valordk/chordata/Renders/Mini HUBs and Mini K-Ceptors - 04p.JPG

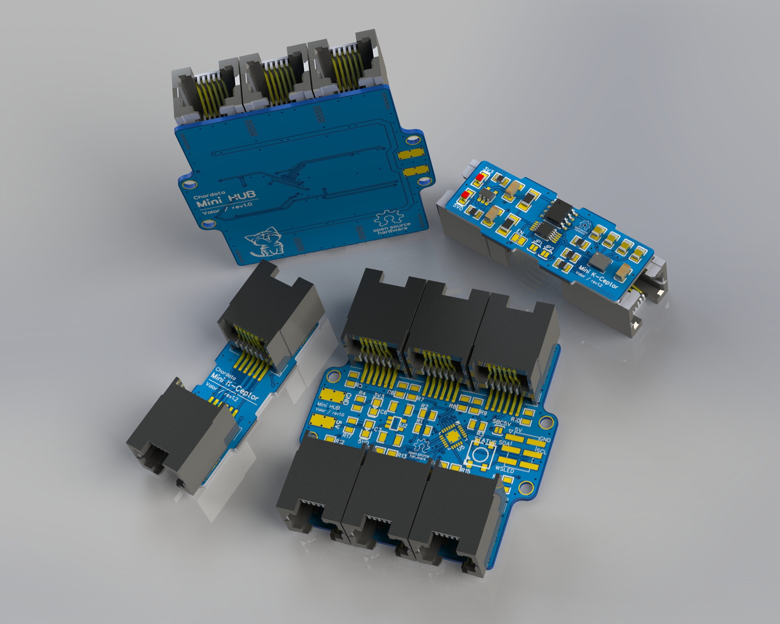
Renders/Mini HUBs and Mini K-Ceptors - 04p.JPG
