valordk/chordata/README.md

# chordata
A smaller version of Chordata Motion Capture system

WIP/LOG at https://forum.chordata.cc/d/71-mini-k-ceptor-design
