valordk/chordata/Mini HUB/Mini HUB - Raspberry Pi connection.png

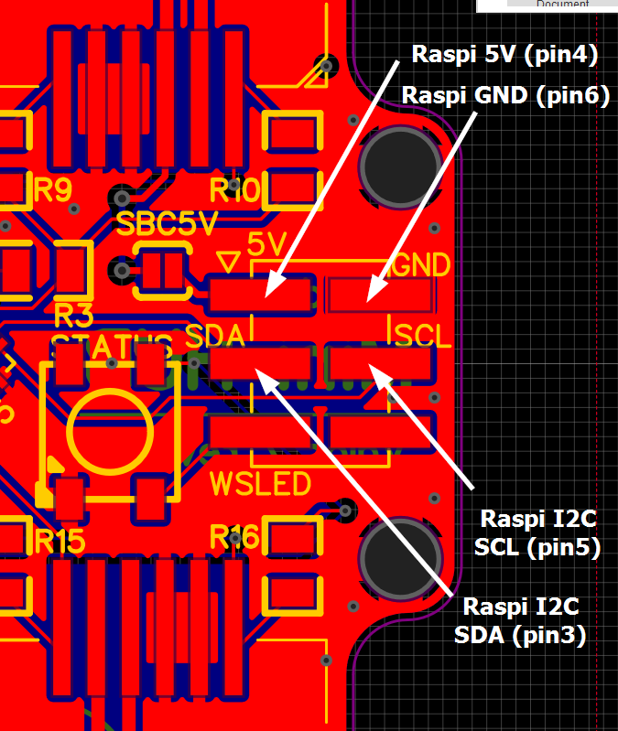
Mini HUB/Mini HUB - Raspberry Pi connection.png
