valordk/chordata/K-Ceptor/Enclosure/Chordata Mini K-Ceptor v1.2 - Case clip.STL

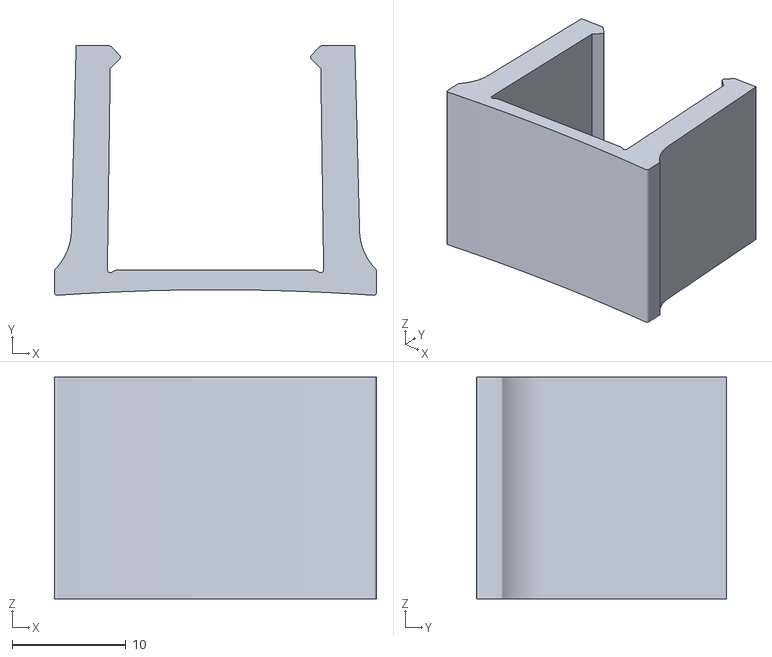
[picture p3: CAD file, 2021-03-20]
K-Ceptor/Enclosure/Chordata Mini K-Ceptor v1.2 - Case clip.STL
28.3 x 21.9 x 19.5
