valordk/chordata/Mini HUB/Enclosure/Chordata - Mini HUB v1 - Casing Bottom.STL

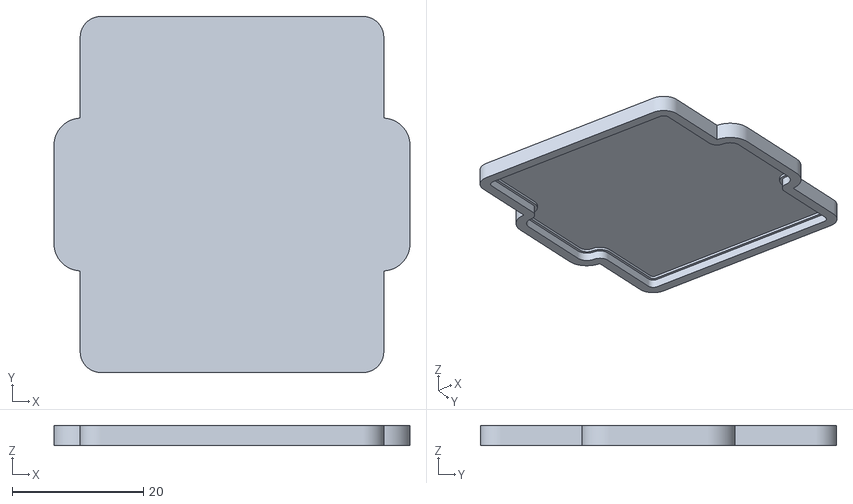
[picture p4: CAD file, 2020-01-15]
Mini HUB/Enclosure/Chordata - Mini HUB v1 - Casing Bottom.STL
54.3 x 54.3 x 3.10
