valordk/chordata/K-Ceptor/Enclosure/Chordata Mini K-Ceptor v1.2 - Casing bottom.STL

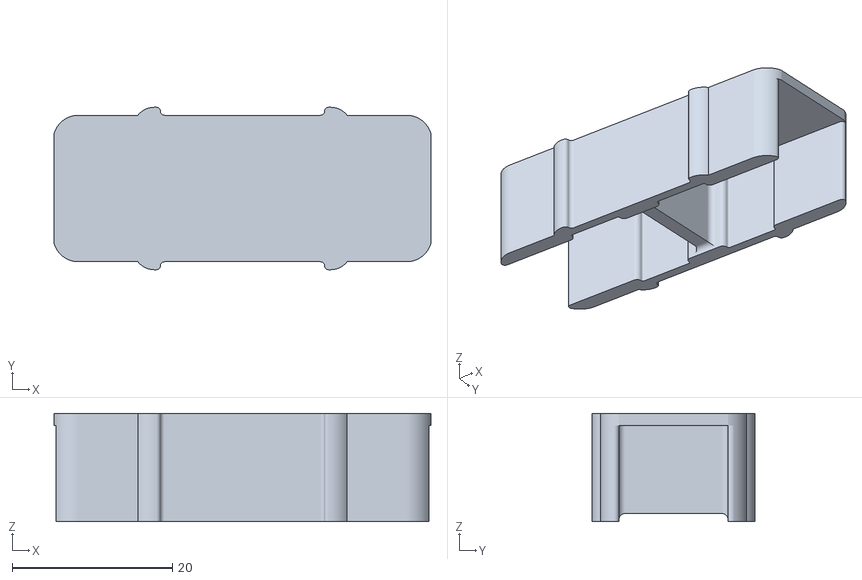
[picture p5: CAD file, 2020-01-13]
K-Ceptor/Enclosure/Chordata Mini K-Ceptor v1.2 - Casing bottom.STL
47.1 x 20.3 x 13.5
