valordk/chordata/(threads)

Thread 1 (2020-04-11):

part corrections for hub

eschultz, 2020-04-11:
Thanks for creating mini versions of the Chordata hub and k-ceptors!

A couple of issues I discovered from the Hub's BOM:

1. #5 HEADER-SBC - Mouser part no. should be 649-1012938390601ALF  with a price of $0.76/each

2. Remove #8 and #9 - they are not used on the Hub

zaanen, 2020-08-09:
Eric is this already fixed or is it still wrong in the BOM ?

valordk, 2020-12-01:
This is now fixed in the latest BOM, as I've updated on the build log: https://forum.chordata.cc/d/71-mini-k-ceptor-design/81

Closed 2020-12-01.

Thread 2 (2020-11-30):

Pick&place/centroid file?

pryda-snare, 2020-11-30:
Could you include a Pick&place/centroid file for ordering assembly? I don't think i can create it from the Gerber Files Alone.

valordk, 2020-12-01:
Hi @pryda-snare ,
The schematics and the PCB sources can also be found on my Easyeda repository

[https://easyeda.com/Muza/vals-chordata](Mini K-Ceptor)
[https://easyeda.com/Muza/vals-chordata-mini-hub-v1_copy](Mini Hub)

I built them by hand so no Pick&Place files were neccessary. You are welcome to clone the Easyeda repos and recheck the parts to ensure that the placement and oritentation fits your assembly fab. and the components they have in stock.

pryda-snare, 2020-12-05:
Hi Valor, 

thanks for your response.
i see only the minihub v. 1.0 on easyeda do you have version 1.3 as on your github?

the k-ceptor is 1.3, which is the newest. 
And have you had success with your design, are they working well?

Dec 1, 2020, 08:56 by notifications@github.com:

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

valordk, 2020-12-05:
The most recent Mini Hub version is v1.0 since it did not require any modifications.
I've built mine and it works. Please refer to Chrodata discussion board where other users are building it.

pryda-snare, 2021-01-04:
Dear valor,

In the kceptor
It seems there are 3 RLB in BOM but only one in the Gerber.

Would you know which is the correct?

5. dec. 2020 17.10 af andersen@tuta.io:

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

valordk, 2021-01-04:
>
> Dear valor, In the kceptor It seems there are 3 RLB in BOM but only one in the Gerber. Would you know which is the correct? 5. dec. 2020 17.10 af andersen@tuta.io:

These are used to set a unique i2c address within a chain. You will have to select one during the assembly of a particular mini K-Ceptor.
These particular values are selected from the datasheet for the LTC4316 i2c Address Translator
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

pryda-snare, 2021-01-04:
Ah so the first in a chain will have R0, then 102k, then 182k.

valordk, 2021-01-04:
Yes ;)

valordk, 2021-01-04:
It's also shown on my build-log at https://forum.chordata.cc/d/71-mini-k-ceptor-design/7

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

Closed 2020-12-09.
