valordk/chordata/(commit log)

2020-01-14 Added Mini K-Ceptor BOM v1.3
    [Chordata Mini K-Ceptor BOM v1.3.xlsx]
2020-01-15 Add 3D printable enclosure for Mini HUB v1
    [Chordata - Mini HUB v1 - Casing Bottom.STL]
2020-03-14 Add BOM for Mini-HUB
    [Chordata Mini HUB BOM v1.3.xlsx]
2020-03-14 Fix RGBLED partnumber on Mini-HUB BOM
    [Chordata Mini HUB BOM v1.3.xlsx]
2020-03-18 Add Mini HUB - Raspberry Pi connection diagram
2020-04-03 Fixed LED pipe part number;
    [Chordata Mini HUB BOM v1.3.xlsx]
2020-11-18 Removed unused capacitor from the Mini-Hub BOM
    [Chordata Mini HUB BOM v1.3.xlsx]
2021-03-20 Added 3d model file for Mini K-Ceptor case clip
    [Chordata Mini K-Ceptor v1.2 - Case clip.STL]
